moschotto/SmartHomeLipoDischarger/media/Lipo_Discharger1.jpg

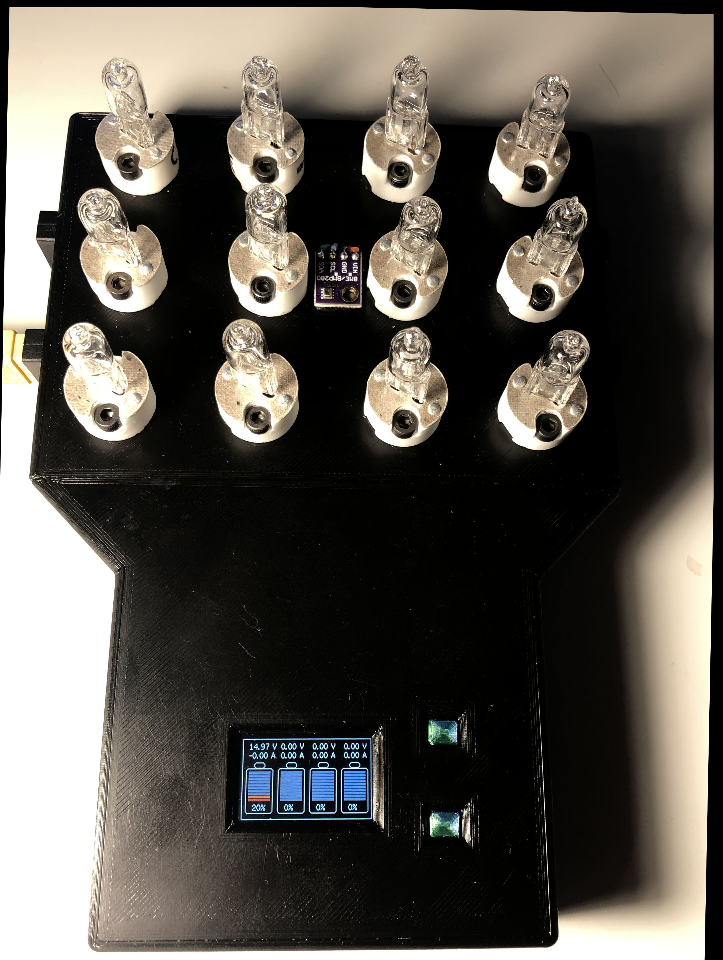
media/Lipo_Discharger1.jpg
