moschotto/SmartHomeLipoDischarger/media/Lipo_Discharger2.jpg

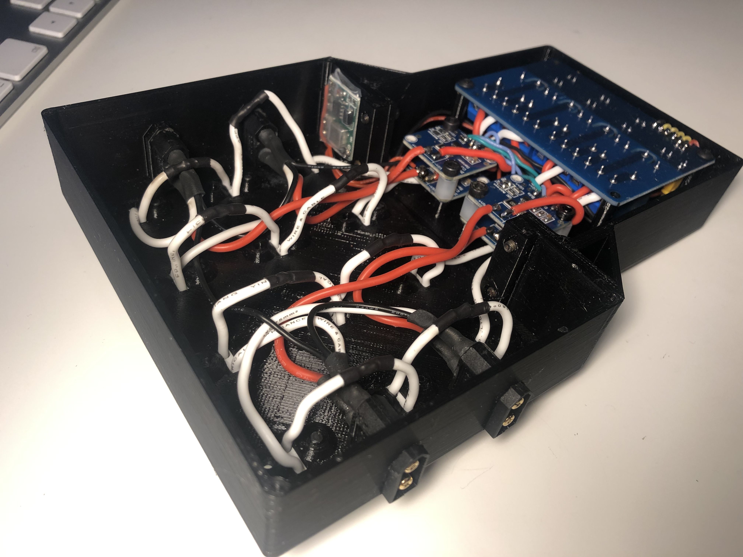
media/Lipo_Discharger2.jpg
