moschotto/SmartHomeLipoDischarger/media/Lipo_Discharger3.jpg

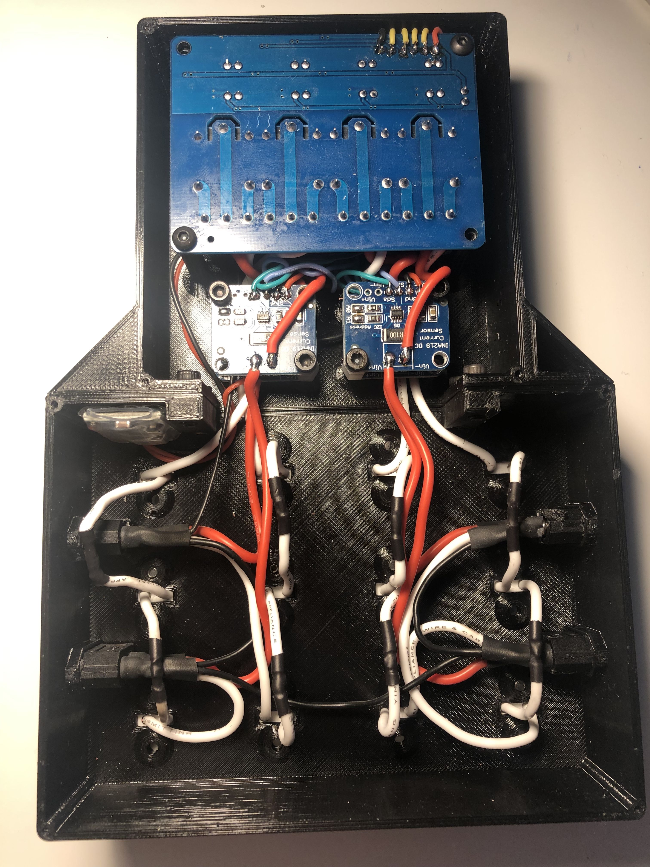
media/Lipo_Discharger3.jpg
