moschotto/SmartHomeLipoDischarger/media/Lipo_Discharger.png

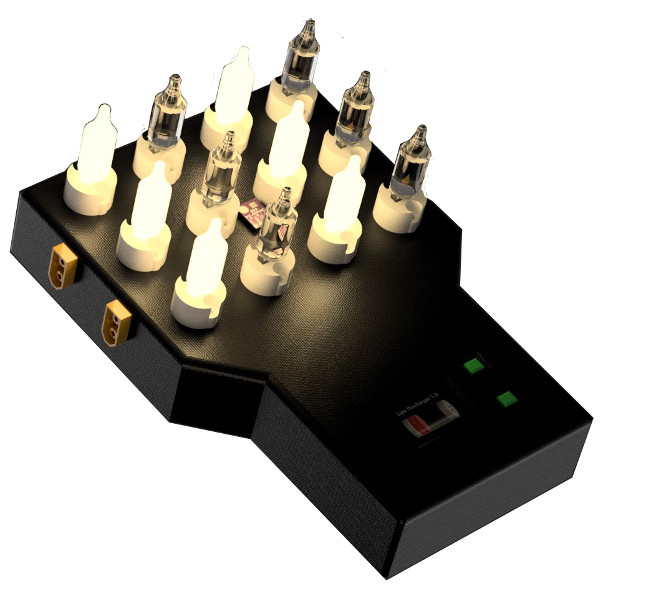
media/Lipo_Discharger.png
