moschotto/SmartHomeLipoDischarger/wiring_diagram.pdf

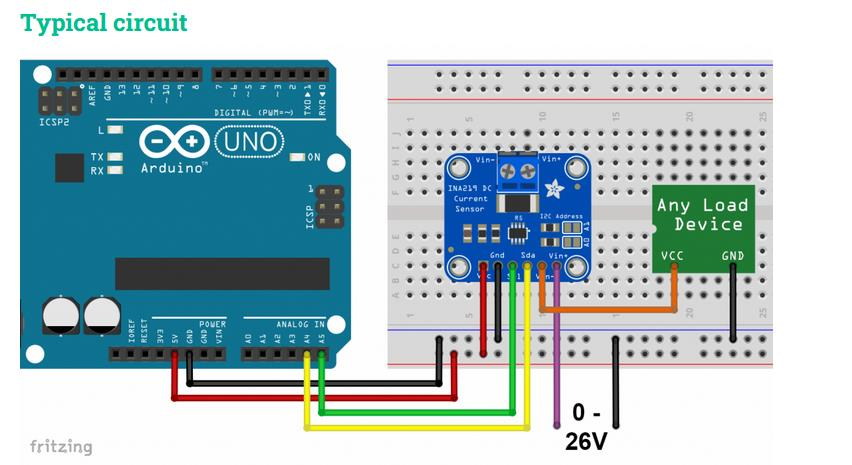
[picture p6: figure]
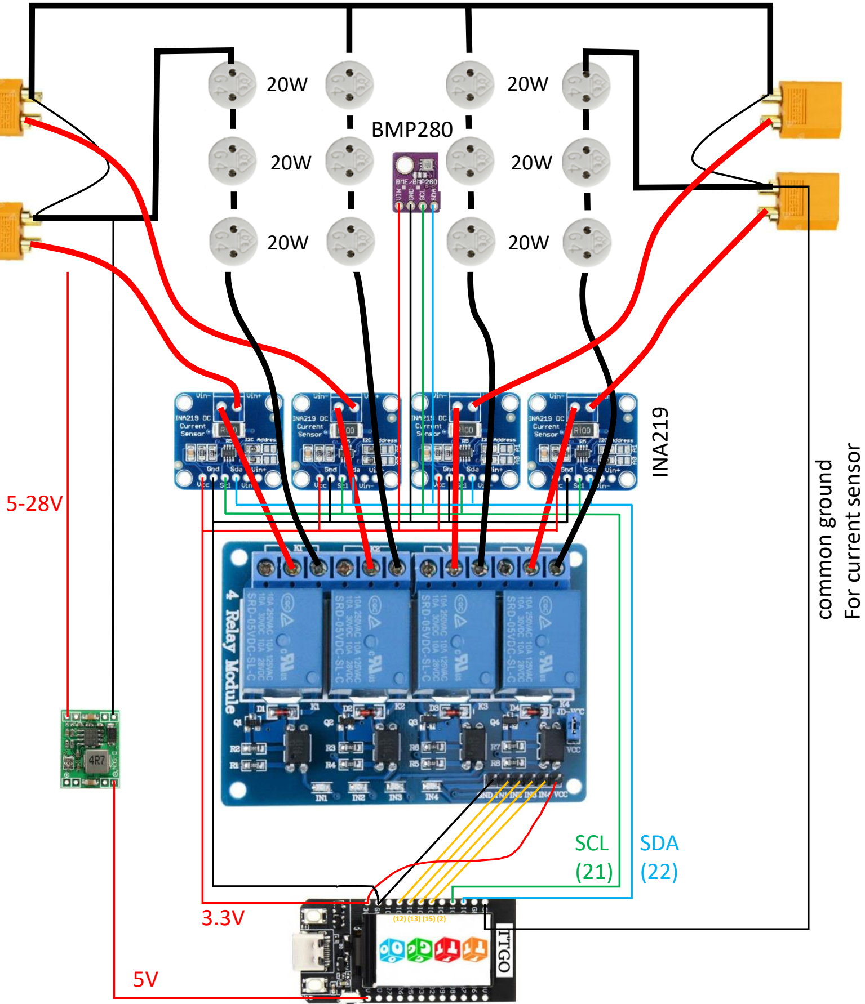
[picture p7: figure]
SDA (22); SCL (21); common ground; For current sensor; INA219; BMP280

Check out this site for details about the current sensor: https://wolles-elektronikkiste.de/en/ina219-current-and-power-sensor
